xumbax/audio_incident_recorder/tools/cyr_font_selfcheck.png

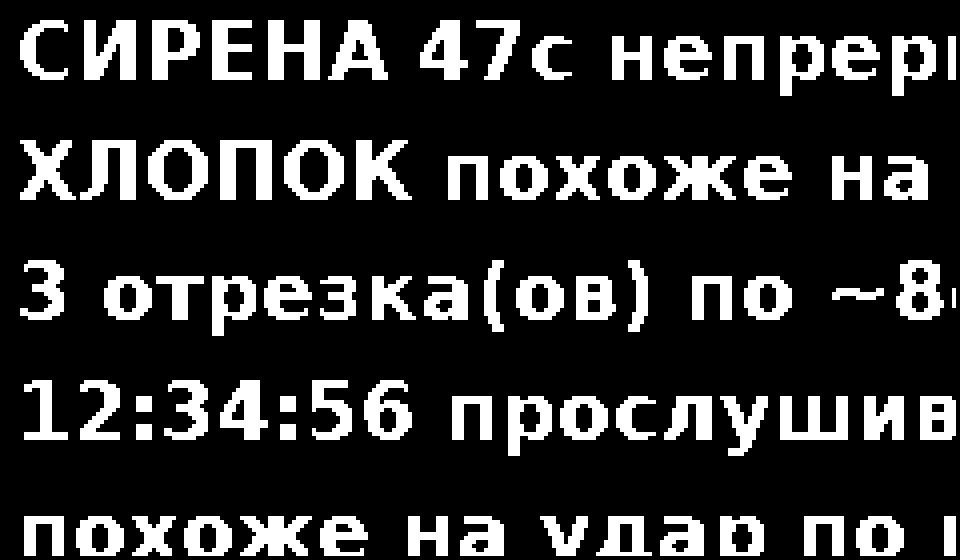
tools/cyr_font_selfcheck.png
