xumbax/audio_incident_recorder/audio_incident_recorder/cyr_font.h

// cyr_font.h — АВТОСГЕНЕРИРОВАНО tools/gen_cyr_font.py, не редактировать руками.
// Источник: /usr/share/fonts/truetype/dejavu/DejaVuSans-Bold.ttf, размер 20px. Формат — GFXfont
// (Adafruit_GFX free font), однобайтовые коды 0x20-0xFF, кириллица в
// раскладке CP1251 (см. cyr_convert.h для UTF-8 -> CP1251).
#pragma once
#include <Arduino.h>
// GFXglyph/GFXfont — типы из TFT_eSPI/Fonts/GFXFF/gfxfont.h. НЕ подключаем
// этот файл сами: TFT_eSPI.h уже подключает его (и объявляет эти типы)
// САМ, но ТОЛЬКО если в User_Setup.h стоит '#define LOAD_GFXFF' — без
// этого объявления типов не будет вообще (не ошибка "файл не найден", а
// непонятное "GFXglyph does not name a type" ниже по этому файлу).
// Раньше здесь был свой '#include <Fonts/GFXFF/gfxfont.h>' — убрали: он не
// спасал от забытого LOAD_GFXFF (сам этот файл тоже завёрнут в '#ifdef
// LOAD_GFXFF'), а только незаметно тянул в каждый .cpp, где подключён этот
// файл, ещё и все ~48 стандартных шрифтов Adafruit_GFX (лишний флеш).
// Поэтому — явная проверка с понятным сообщением вместо каскада невнятных
// ошибок компилятора:
#ifndef LOAD_GFXFF
#error "LOAD_GFXFF не определён. Добавьте '#define LOAD_GFXFF' в TFT_eSPI/User_Setup.h (см. README.md, раздел 'Настройка окружения') — без него кириллический шрифт не соберётся, и подключать этот файл (cyr_font.h) нужно ПОСЛЕ <TFT_eSPI.h>."
#endif

const uint8_t CyrFont20Bitmaps[] PROGMEM = {
    0x73, 0x9C, 0xE7, 0x39, 0xCE, 0x73, 0x80, 0xE7, 0x39, 0xC0, 0x67, 0x67, 0x67, 0x67, 0x67, 0x03,
    0x38, 0x0E, 0x60, 0x18, 0xC0, 0x31, 0x87, 0xFF, 0xCF, 0xFF, 0x83, 0x18, 0x06, 0x30, 0x0C, 0xE1,
    0xFF, 0xF3, 0xFF, 0xE0, 0xC6, 0x01, 0x9C, 0x07, 0x30, 0x0C, 0x60, 0x00, 0x06, 0x00, 0x60, 0x1F,
    0x87, 0xFE, 0x76, 0x67, 0x60, 0x76, 0x07, 0xF8, 0x3F, 0xE1, 0xFE, 0x07, 0xE0, 0x6F, 0x46, 0xE7,
    0xFE, 0x3F, 0x80, 0x60, 0x06, 0x00, 0x60, 0x3E, 0x06, 0x07, 0xF0, 0x60, 0x73, 0x0C, 0x06, 0x31,
    0xC0, 0x63, 0x18, 0x07, 0x33, 0x00, 0x7F, 0x30, 0x03, 0xE6, 0x7C, 0x00, 0xEF, 0xE0, 0x0C, 0xEE,
    0x01, 0x8C, 0x60, 0x18, 0xC6, 0x03, 0x0E, 0xE0, 0x60, 0xFE, 0x06, 0x07, 0xC0, 0x07, 0x80, 0x1F,
    0xE0, 0x1C, 0x20, 0x3C, 0x00, 0x1C, 0x00, 0x1E, 0x00, 0x3F, 0x0E, 0x7F, 0x8E, 0x73, 0xDE, 0xF3,
    0xFC, 0xF1, 0xFC, 0xF0, 0xF8, 0x78, 0xF8, 0x3F, 0xFC, 0x1F, 0x9E, 0x66, 0x66, 0x60, 0x1C, 0x38,
    0xE1, 0xC3, 0x8E, 0x1C, 0x38, 0x70, 0xE1, 0xC3, 0x87, 0x0F, 0x0E, 0x1C, 0x1C, 0x38, 0x70, 0xE0,
    0xE1, 0xC3, 0xC3, 0x87, 0x0E, 0x1C, 0x38, 0x70, 0xE1, 0xC7, 0x8E, 0x1C, 0x70, 0xE0, 0x0C, 0x03,
    0x04, 0xCD, 0xFE, 0x1E, 0x1F, 0xE4, 0xCC, 0x30, 0x0C, 0x00, 0x07, 0x00, 0x38, 0x01, 0xC0, 0x0E,
    0x00, 0x70, 0x7F, 0xFF, 0xFF, 0xE0, 0xE0, 0x07, 0x00, 0x38, 0x01, 0xC0, 0x0E, 0x00, 0x7B, 0xDE,
    0xE7, 0x73, 0x00, 0xFD, 0xFB, 0xF0, 0xFF, 0xFF, 0x06, 0x06, 0x0E, 0x0C, 0x0C, 0x1C, 0x18, 0x18,
    0x38, 0x30, 0x30, 0x70, 0x60, 0x60, 0xE0, 0xC0, 0x0F, 0x80, 0xFF, 0x0F, 0x3C, 0x70, 0xE7, 0x87,
    0xBC, 0x3D, 0xE1, 0xEF, 0x0F, 0x78, 0x7B, 0xC3, 0xDE, 0x1E, 0x70, 0xE3, 0xCF, 0x0F, 0xF0, 0x3E,
    0x00, 0x3E, 0x1F, 0xC3, 0x38, 0x07, 0x00, 0xE0, 0x1C, 0x03, 0x80, 0x70, 0x0E, 0x01, 0xC0, 0x38,
    0x07, 0x00, 0xE1, 0xFF, 0xFF, 0xF8, 0x3F, 0x07, 0xFC, 0x63, 0xE0, 0x1E, 0x01, 0xE0, 0x1E, 0x01,
    0xE0, 0x3C, 0x07, 0x80, 0xF0, 0x1E, 0x03, 0xC0, 0x78, 0x07, 0xFE, 0x7F, 0xE0, 0x3F, 0x87, 0xFC,
    0x43, 0xE0, 0x1E, 0x01, 0xE0, 0x3C, 0x1F, 0x81, 0xFC, 0x03, 0xE0, 0x1E, 0x00, 0xE0, 0x1E, 0xC3,
    0xEF, 0xFC, 0x3F, 0x00, 0x03, 0xE0, 0x1F, 0x01, 0xF8, 0x1F, 0xC0, 0xFE, 0x0E, 0xF0, 0xE7, 0x87,
    0x3C, 0x71, 0xE3, 0x8F, 0x1F, 0xFE, 0xFF, 0xF0, 0x1E, 0x00, 0xF0, 0x07, 0x80, 0x7F, 0xC7, 0xFC,
    0x70, 0x07, 0x00, 0x70, 0x07, 0xF8, 0x7F, 0xC4, 0x3E, 0x01, 0xE0, 0x0E, 0x00, 0xE0, 0x1E, 0x43,
    0xE7, 0xFC, 0x3F, 0x00, 0x0F, 0xC1, 0xFE, 0x3C, 0x27, 0x80, 0x70, 0x0F, 0x78, 0xFF, 0xEF, 0x9E,
    0xF0, 0xFF, 0x0F, 0x70, 0xF7, 0x0F, 0x79, 0xE3, 0xFC, 0x0F, 0x80, 0xFF, 0xEF, 0xFE, 0x01, 0xE0,
    0x1E, 0x03, 0xC0, 0x3C, 0x07, 0x80, 0x78, 0x07, 0x80, 0xF0, 0x0F, 0x01, 0xE0, 0x1E, 0x01, 0xC0,
    0x3C, 0x00, 0x1F, 0x87, 0xFE, 0x79, 0xE7, 0x0E, 0x70, 0xE7, 0x9E, 0x3F, 0xC3, 0xFC, 0x79, 0xEF,
    0x0E, 0xF0, 0xFF, 0x0F, 0x79, 0xE7, 0xFE, 0x1F, 0x80, 0x1F, 0x03, 0xFC, 0x71, 0xCF, 0x1E, 0xF0,
    0xEF, 0x0F, 0xF1, 0xF7, 0x1F, 0x7F, 0xF1, 0xEE, 0x00, 0xE0, 0x1E, 0x43, 0xC7, 0xF8, 0x3F, 0x00,
    0xFF, 0xFF, 0x00, 0x0F, 0xFF, 0xF0, 0x7B, 0xDE, 0xF0, 0x00, 0x0F, 0x7B, 0xDE, 0xE6, 0x70, 0x00,
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
    { 640, 13, 15, 15, 1, -15 },
    { 665, 15, 15, 17, 1, -15 },
    { 694, 12, 15, 14, 1, -15 },
    { 717, 11, 15, 14, 1, -15 },
    { 738, 14, 15, 16, 1, -15 },
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
};

const GFXfont CyrFont20 PROGMEM = {
    (uint8_t *)CyrFont20Bitmaps, (GFXglyph *)CyrFont20Glyphs,
    0x20, 0xFF, 26
};
