xumbax/audio_incident_recorder/audio_incident_recorder/bang_classifier.h

// bang_classifier.h
// Классификация короткого импульсного события ("хлопка") по сырому
// захваченному фрагменту: гроза / выстрел / взрыв / удар по металлу.
//
// ВАЖНО: пороги в bang_classifier.cpp — стартовое приближение по общим
// акустическим признакам, не результат обучения на размеченных записях.
// Это осознанное решение (см. обсуждение в audio-incident-recorder-design.md):
// у одного всенаправленного микрофона нет шансов на 100% точность, поэтому
// каждое событие ВСЕГДА пишется как WAV на SD — прослушать и на основе
// реальных записей подправить константы THUNDER/GUNSHOT/EXPLOSION/METAL_*
// в .cpp (они помечены "TUNE ME").
#pragma once
#include "event_types.h"

// samples/numSamples — захваченный фрагмент события (моно int16, 16 кГц).
BangResult classifyBang(const int16_t *samples, size_t numSamples);
